vladchelaru22/LF-Signal-Generator/README.md

# Low Frequency Signal Generator
Designed and implemented (Schematic, PCB Design + Physical Module) an LF Generator capable of outputting Sine, Triangle and Square waveforms, as well as adjusting amplitude and frequency in the range of 100Hz-5Khz using potentiometers
