vladchelaru22/LF-Signal-Generator/LAYER PICTURES/BO.jpg

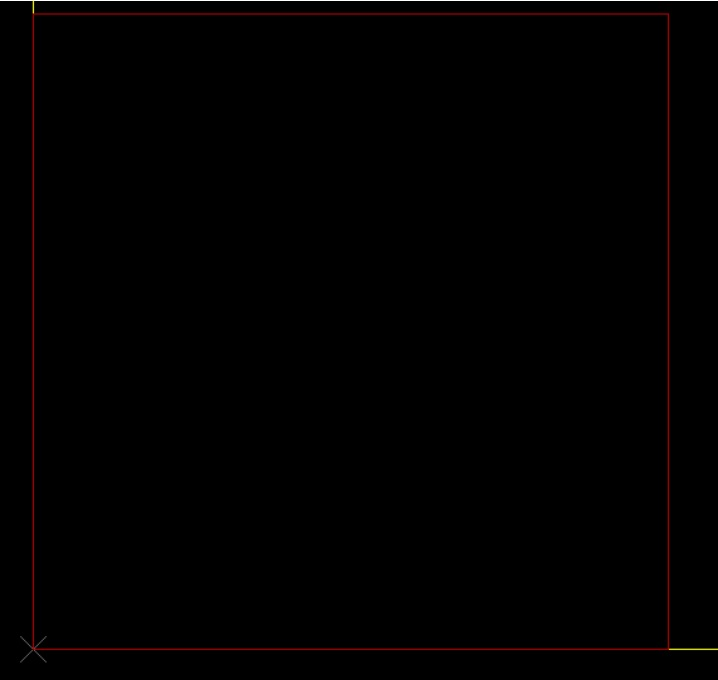
LAYER PICTURES/BO.jpg
