vladchelaru22/LF-Signal-Generator/LAYER PICTURES/BOT.jpg

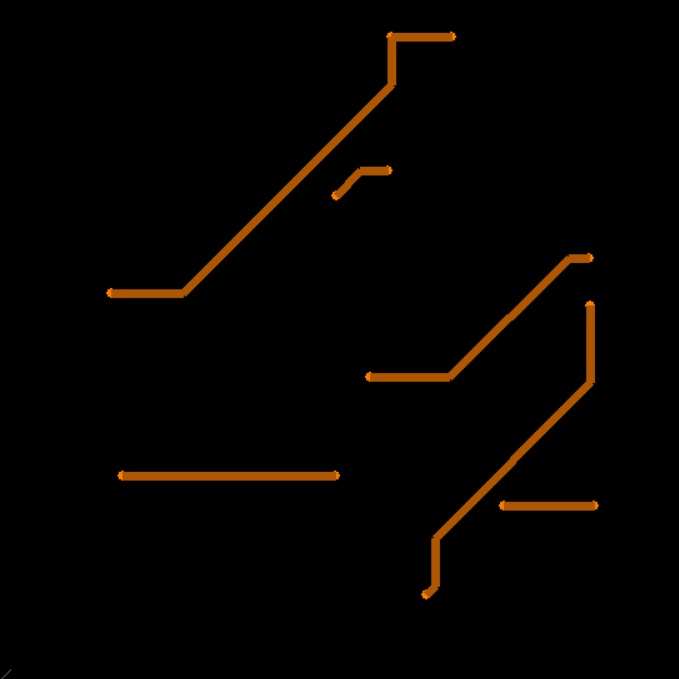
LAYER PICTURES/BOT.jpg
