vladchelaru22/LF-Signal-Generator/LAYER PICTURES/DRILL.jpg

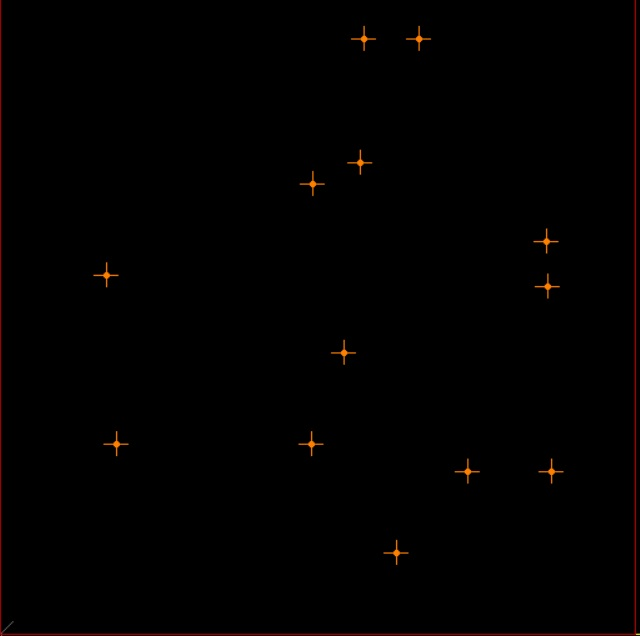
LAYER PICTURES/DRILL.jpg
