vladchelaru22/LF-Signal-Generator/LAYER PICTURES/SMBOT.jpg

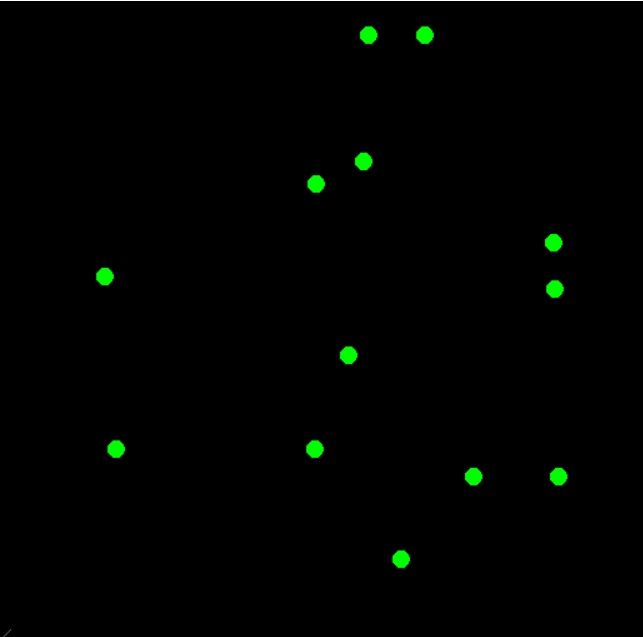
LAYER PICTURES/SMBOT.jpg
