vladchelaru22/LF-Signal-Generator/LAYER PICTURES/SMTOP.jpg

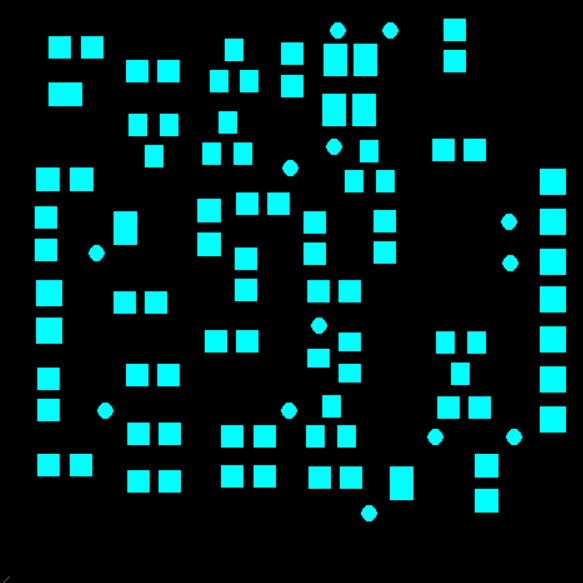
LAYER PICTURES/SMTOP.jpg
