vladchelaru22/LF-Signal-Generator/LAYER PICTURES/SPTOP.jpg

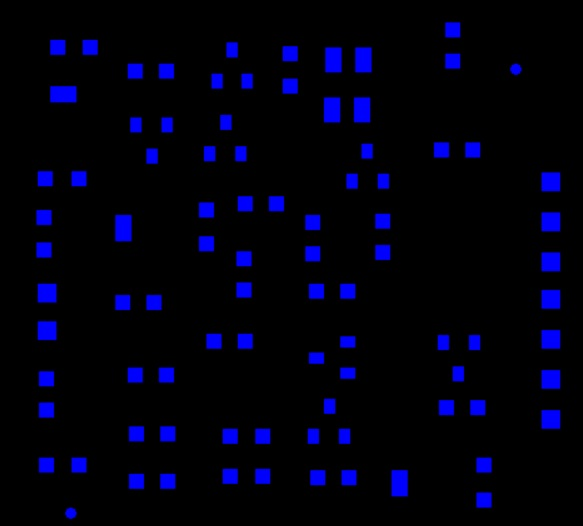
LAYER PICTURES/SPTOP.jpg
