vladchelaru22/LF-Signal-Generator/LAYER PICTURES/SSTOP.jpg

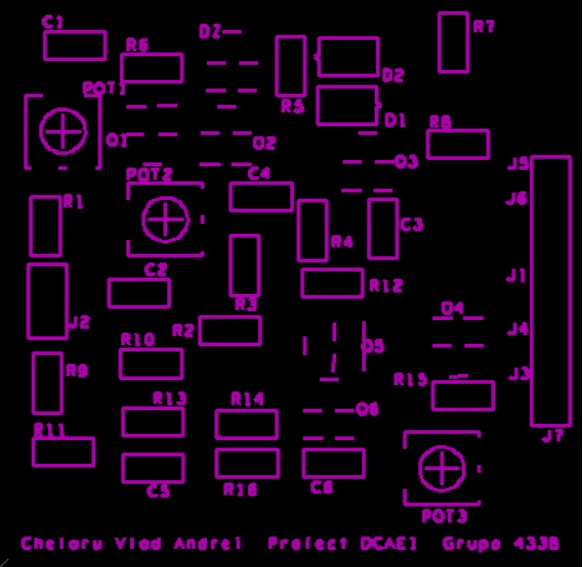
LAYER PICTURES/SSTOP.jpg
