vladchelaru22/LF-Signal-Generator/LAYER PICTURES/TOP.jpg

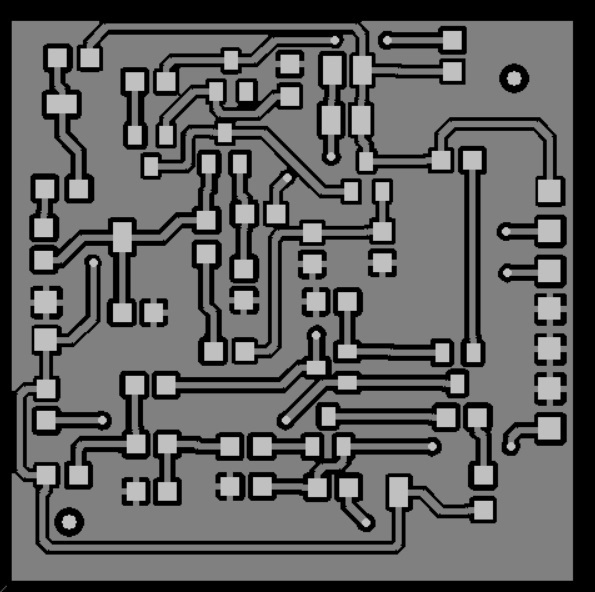
LAYER PICTURES/TOP.jpg
