vladchelaru22/LF-Signal-Generator/BOM_P1_Chelaru_Vlad_Andrei.xlsx

INDEX | REFERINTA | VALOARE | CANTITATE | CAPSULA | PRODUCATOR | COD PROD. | DISTRIBUITOR | COD DISTRIBUITOR | DESCRIERE
1 | C1,C2 | 220n | 2 | SMD CAP 0805 | SAMSUNG | CL21B224KAFNNNE | TME România | CL21B224KAFNNNE | Condensator: ceramic; MLCC; 220nF; 25V; X7R; ±10%; SMD; 0805
2 | C3,C4 | 4.7u | 2 | SMD CAP 0805 | SAMSUNG | CL21A475KAQNNNG | TME România | CL21A475KAQNNNG | Condensator: ceramic; MLCC; 4,7uF; 25V; X5R; ±10%; SMD; 0805
4 | C6 | 1n | 1 | SMD CAP 0805 | SAMSUNG | CL21C102JBCNNNC | TME România | CL21C102JBCNNNC | Condensator MLCC, SMD, 0805, 1nF, ±5%, 50V, C0G
5 | D1,D2 | D1N4148 | 2 | SMD 0805 | DC Components | CD4148WS | TME România | 1N4148-0805 | Diodă comutație, SMD, 0805, 300mA, 100V
6 | Dz | BZX84C2V7 | 1 | SOT23 | ON Semiconductor | BZX84-C2V7,215 | TME România | BZX84C2V7 | Diodă Zener, SMD, SOT23, 2,7V, ±5%, 0.25W
7 | POT1,POT2,POT3 | 10k | 3 | SMD 4.5x4.5x2.55mm | BOURNS | 3314G-1-103E | TME România | 3314G-1-103E | Potențiome-tru liniar, simplă tură, SMD, 10kΩ, ±20%, 100ppm/°C, 0.25W
8 | Q2,Q3,Q4,Q5 | BC846B | 4 | SOT23 | DIOTEC | BC846B | TME România | BC856B | Tranzistor bipolar NPN, SMD, SOT23, 65V, 100mA
9 | Q1,Q6 | BC856B | 2 | SOT23 | DIOTEC | BC856B | TME România | BC856B | Tranzistor bipolar PNP, SMD, SOT23, 65V, 100mA
10 | R1,R2 | 100 | 2 | SMD RES 0805 | ROYAL OHM | 0805S8J0101T5E | TME România | SMD0805-100R-5% | Rezistor SMD, chip, 0805, 100Ω, ±5%, 0.125W
11 | R3 | 3.3k | 1 | SMD RES 0805 | ROYAL OHM | 0805S8J0332T5E | TME România | SMD0805-3K3-5% | Rezistor SMD, chip, 0805, 3.3kΩ, ±5%, 0.125W
12 | R4,R7 | 220 | 2 | SMD RES 0805 | ROYAL OHM | 0805S8F2200T5E | TME România | SMD0805-220R-5% | Rezistor SMD, chip, 0805, 220Ω, ±5%, 0.125W
13 | R5 | 2.2k | 1 | SMD RES 0805 | ROYAL OHM | 0805S8J0222T5E | TME România | SMD0805-2K2-5% | Rezistor SMD, chip, 0805, 2.2kΩ, ±5%, 0.125W
14 | R6 | 2k | 1 | SMD RES 0805 | ROYAL OHM | 0805S8J0202T5E | TME România | SMD0805-2K-5% | Rezistor SMD, chip, 0805, 2kΩ, ±5%, 0.125W
15 | R8 | 150k | 1 | SMD RES 0805 | ROYAL OHM | 0805S8J0154T5E | TME România | SMD0805-150K-5% | Rezistor SMD, chip, 0805, 150kΩ, ±5%, 0.125W
16 | R9,R11,R15 | 1k | 3 | SMD RES 0805 | ROYAL OHM | 0805S8J0102T5E | TME România | SMD0805-1K-5% | Rezistor SMD, chip, 0805, 1kΩ, ±5%, 0.125W
17 | R10,R13 | 4.7k | 2 | SMD RES 0805 | ROYAL OHM | 0805S8J0472T5E | TME România | SMD0805-4K7-5% | Rezistor SMD, chip, 0805, 4.7kΩ, ±5%, 0.125W
18 | R12 | 51 | 1 | SMD RES 0805 | YAGEO | RC0805JR-0751RL | TME România | SMD0805-51R-5% | Rezistor SMD, chip, 0805, 51Ω, ±5%, 0.125W
19 | R14 | 22k | 1 | SMD RES 0805 | ROYAL OHM | 0805S8J0223T5E | TME România | SMD0805-22K-5% | Rezistor SMD, chip, 0805, 22kΩ, ±5%, 0.125W
20 | R16 | 100k | 1 | SMD RES 0805 | ROYAL OHM | 0805S8J0104T5E | TME România | SMD0805-100K-5% | Rezistor SMD, chip, 0805, 100kΩ, ±5%, 0.125W
Conectoare pentru testare sau conexiuni externe (nu necesita componenta fizica)
21 | J1, J2,J3, J4, J5, J6 | con 1 pin/con 2 pini | 1 | ZL301-40P | NINIGI | ZL301-40P | TME România | ZL301-40P | Sir pini, pas 2,54mm, SMD, tip tata, bareta de 40 pini
