vladchelaru22/LF-Signal-Generator/Final_Schematic.pdf

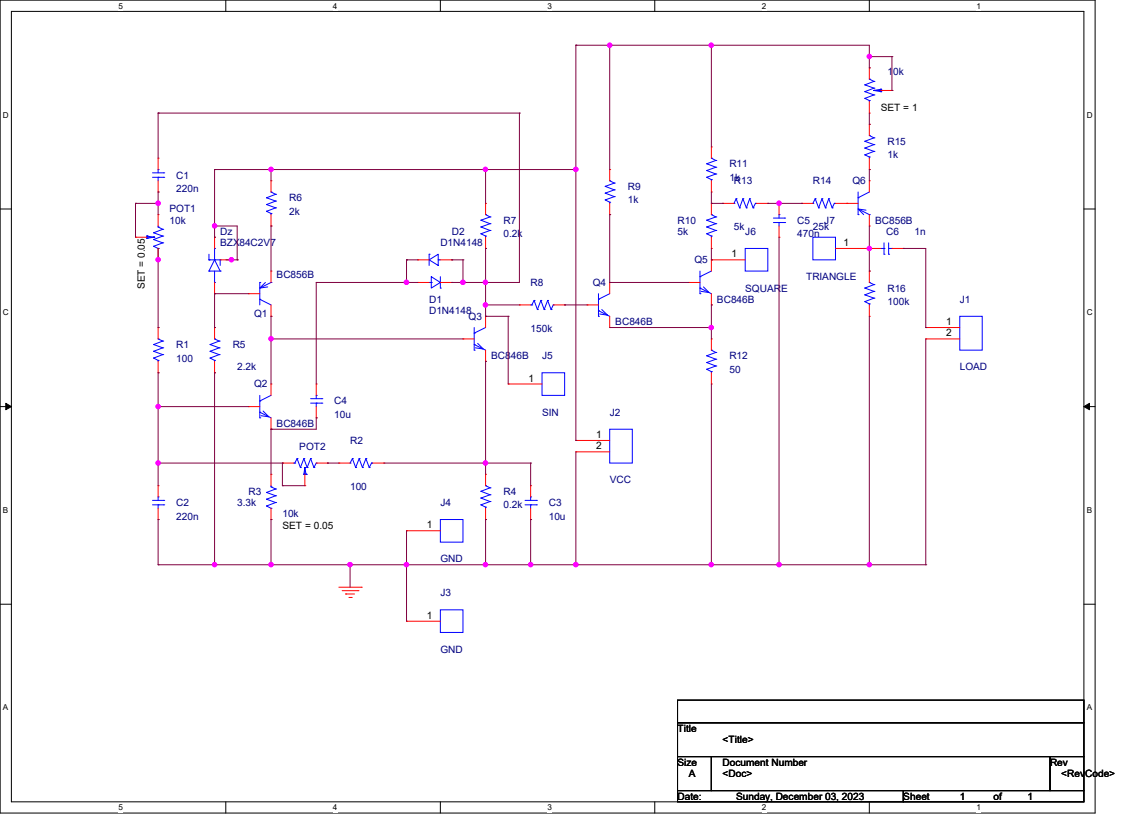
[picture p34: page 1]
