vladchelaru22/LF-Signal-Generator/p1-PSpiceFiles/SCHEMATIC2/oscilator/oscilator.cir

** Profile: "SCHEMATIC2-oscilator"  [ c:\users\vladc\desktop\tie\p1-pspicefiles\schematic2\oscilator.sim ] 

** Creating circuit file "oscilator.cir" 
** WARNING: THIS AUTOMATICALLY GENERATED FILE MAY BE OVERWRITTEN BY SUBSEQUENT SIMULATIONS

*Libraries: 
* Profile Libraries :
* Local Libraries :
* From [PSPICE NETLIST] section of C:\Users\vladc\AppData\Roaming\SPB_16.6\cdssetup\OrCAD_PSpice\17.2.0\PSpice.ini file:
.lib "nomd.lib" 

*Analysis directives: 
.TRAN  0 5 0.1 20u 
.OPTIONS ADVCONV
.PROBE64 V(alias(*)) I(alias(*)) W(alias(*)) D(alias(*)) NOISE(alias(*)) 
.INC "..\SCHEMATIC2.net" 


.END
