vladchelaru22/LF-Signal-Generator/(list of files, drawings)

Other design files:
OSCILATOR.DSN
oscilator.opj
P1.DSN
p1.opj
